ZaneMorris/RomniBot/RomniBot_BOM.xlsx

Assy Level 1 | Assy Level 2 | Assy Level 3 | Description | Qty. | Type | Material
OD_A1 |  |  | Chassis Assy | 1 | ASSY | N/A
 | OD_A1_A1 |  | Electronics Assy | 1 | ASSY | N/A
 |  | OD_A1_A1_001 | Electronic Bay Baseplate | 1 | Print | PLA
 |  | OD_A1_A1_002 | Antenna Mount | 1 | Print | PLA
 |  | OD_A1_A1_003 | FHCS cntsk washer (for PCB mounts) | 16 | Print | PLA
 |  | OD_A1_A1_004 | Perfboard 1 | 1 | Elec. | Perfboard
 |  | 91420A020 | M2.5 x 0.45mm x 10mm FHCS | 18 | Hardware | Steel
 |  | N/A | Male 2.54mm headers | 21 | Elec. | N/A
 |  | LM2596S | buck converter (breakout board) (https://www.amazon.ca/gp/product/B07VVXF7YX/ref=ppx_yo_dt_b_asin_title_o05_s00?ie=UTF8&psc=1) | 2 | Elec. | N/A
 |  | L298N | DC dual motor driver (breakout board) (https://www.amazon.ca/gp/product/B07GTCWN9Z/ref=ppx_yo_dt_b_asin_title_o00_s01?ie=UTF8&psc=1) | 2 | Elec. | N/A
 |  | NRF24L01 | Transciever module with booster antenna (https://www.amazon.ca/Jweweunyu-NRF24L01-Transceiver-Antenna-Wireless/dp/B0B7QG4HV8) | 1 | Elec. | N/A
 | OD_A1_001 |  | Chassis Assy | 1F 1R | ASSY | N/A
 | OD_A1_002 |  | #10-24 UNC threaded rod | 2 | Hardware | Mild Steel
 | OD_A1_003 |  | Electronic bay lid | 1 | Laser | 1/16" Acrylic
 | OD_A1_004 |  | Electronic baseplate standoffs | 4 | Print | PLA
 | OD_G_A1 |  | Front motor bracket Assy | 4 | ASSY | N/A
 |  | OD_G_A1_001 | Front motor bracket | 1 | Print | PLA
 |  | N/A | M3 threaded brass heat-set inserts (https://www.amazon.ca/gp/product/B087N4LVD1/ref=ppx_yo_dt_b_asin_title_o03_s00?ie=UTF8&psc=1) | 3 | Hardware | Brass
 | OD_G_A2 |  | Rear motor bracket Assy | 4 | ASSY | N/A
 |  | OD_G_A2_001 | Rear motor bracket | 1 | Print | PLA
 |  | N/A | M3 threaded brass heat-set inserts (https://www.amazon.ca/gp/product/B087N4LVD1/ref=ppx_yo_dt_b_asin_title_o03_s00?ie=UTF8&psc=1) | 2 | Hardware | Brass
 | 91290A175 |  | M4 x 0.7 x 45mm SHCS - Electronics bay standoff bolt | 4 | Hardware | Black Oxide Steel
 | 91420A020 |  | M2.5 x 0.45mm x 10mm FHCS - Electronic bay lid screws | motor screws | 12 | Hardware | Zinc-Plated Steel
 | 90593A003 |  | M4 x 0.7mm nut | 4 | Hardware | Black Oxide Steel
 | 91290a117 |  | M3 x 0.5mm x 12mm SHCS | 20 | Hardware | Black Oxide Steel
 | 90480A011 |  | #10-24 UNC nut | 4 | Hardware | Zinc-Plated Steel
 | 97416A115 |  | #10 washer | 4 | Hardware | Black Oxide Steel
 | N/A |  | 12V DC motor, D-shaft (https://www.amazon.ca/gp/product/B07D297L9F/ref=ppx_yo_dt_b_asin_title_o07_s00?ie=UTF8&psc=1) | 4 | Elec. | N/A
 | N/A |  | ERB 3300 mAh 60C 14.8V LiPo battery (w Deans connector) (https://www.amazon.ca/gp/product/B06XKQJZ8D/ref=ppx_yo_dt_b_asin_title_o00_s00?ie=UTF8&psc=1) | 1 | Elec. | N/A
 | N/A |  | T Plug - to - cable adapter (12 AWG output) (https://www.amazon.ca/gp/product/B07QM1WS2J/ref=ppx_yo_dt_b_asin_title_o04_s00?ie=UTF8&psc=1) | 1 | Elec. | N/A
 | KCDY-101 |  | 8A, 250 VAC | 10A, 125 VAC SPST power switch | 1 | Elec. | N/A
 | N/A |  | MINI-DVM-3.0-30V-GREEN-LED | 1 | Elec. | N/A
OD_A2 |  |  | Wheel Config 1 | 2 | ASSY | N/A
 | OD_A2_001 |  | Mecanum wheel rim | 1R 1L | Print | PLA
 | OD_G_001 |  | Wheel spacer | 3 | Print | PLA
 | OD_G_002 |  | Roller | 9 | Print | PLA
 | OD_G_003 |  | Roller pin | 9 | Print | PLA
 | OD_G_004 |  | Motor-Wheel adapter | 1 | Print | PLA
 | 6658K724 |  | Oil-embedded bronze bushing (NOT USED) | 18 | Hardware | 841 Bearing Bronze
 | 91290A268 |  | M5 x 0.8mm x 60mm SHCS | 3 | Hardware | Black Oxide Steel
 | 98541A113 |  | 5mm OD shaft external retaining ring | 9 | Hardware | Black Oxide Steel
 | 91390A101 |  | M3 x 0.5mm x 8mm cupped marring set screw | 1 | Hardware | Black Oxide Steel
 | 90593A001 |  | M3 x 0.5mm nut | 1 | Hardware | Black Oxide Steel
 | 91880A037 |  | M5 x 0.8mm cap nut (NOT USED - currently M5 x 0.8mm nut - 90592A095) | 3 | Hardware | Zinc-Plated Steel
OD_A3 |  |  | Wheel Config 2 | 2 | ASSY | N/A
 | OD_A3_001 |  | Mecanum wheel rim | 1R 1L | Print | PLA
 | OD_G_001 |  | Wheel spacer | 3 | Print | PLA
 | OD_G_002 |  | Roller | 9 | Print | PLA
 | OD_G_003 |  | Roller pin | 9 | Print | PLA
 | OD_G_004 |  | Motor-Wheel adapter | 1 | Print | PLA
 | 6658K724 |  | Oil-embedded bronze bushing (NOT USED) | 18 | Hardware | 841 Bearing Bronze
 | 91290A268 |  | M5 x 0.8mm x 60mm SHCS | 3 | Hardware | Black Oxide Steel
 | 98541A113 |  | 5mm OD shaft external retaining ring | 9 | Hardware | 1060 Spring Steel
 | 91390A101 |  | M3 x 0.5mm x 8mm cupped marring set screw | 1 | Hardware | Black Oxide Steel
 | 90593A001 |  | M3 x 0.5mm nut | 1 | Hardware | Black Oxide Steel
 | 91880A037 |  | M5 x 0.8mm cap nut (NOT USED - currently M5 x 0.8mm nut - 90592A095) | 3 | Hardware | Zinc-Plated Steel
Other Useful Links
General M3/M4/M5 SHCS and Nuts (https://www.amazon.ca/gp/product/B0734NVR48/ref=ppx_yo_dt_b_asin_title_o02_s00?ie=UTF8&psc=1)
Solid core 22 AWG wire (https://www.amazon.ca/gp/product/B0791C1XHK/ref=ppx_yo_dt_b_asin_title_o02_s00?ie=UTF8&psc=1)
Heat shrink (https://www.amazon.ca/gp/product/B07SMBDLGQ/ref=ppx_yo_dt_b_asin_title_o04_s00?ie=UTF8&psc=1)
