ZaneMorris/RomniBot/CAD/Electronics/NRF24L01L+Antenna.SLDASM

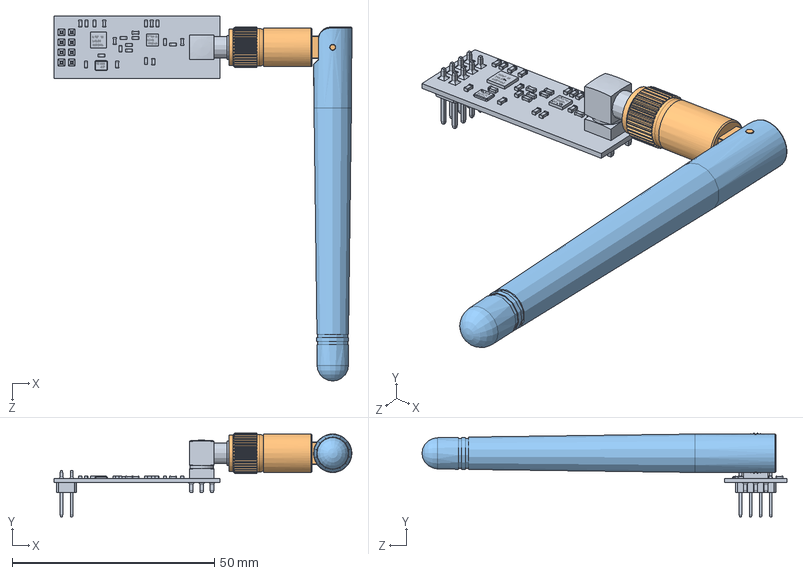
[picture p1: CAD file, 2023-05-12]
CAD/Electronics/NRF24L01L+Antenna.SLDASM
73.7 x 20.7 x 90.2 mm
NRF24L01L
Antenna base
Antenna top
