ZaneMorris/RomniBot/CAD/OD_A2.SLDASM

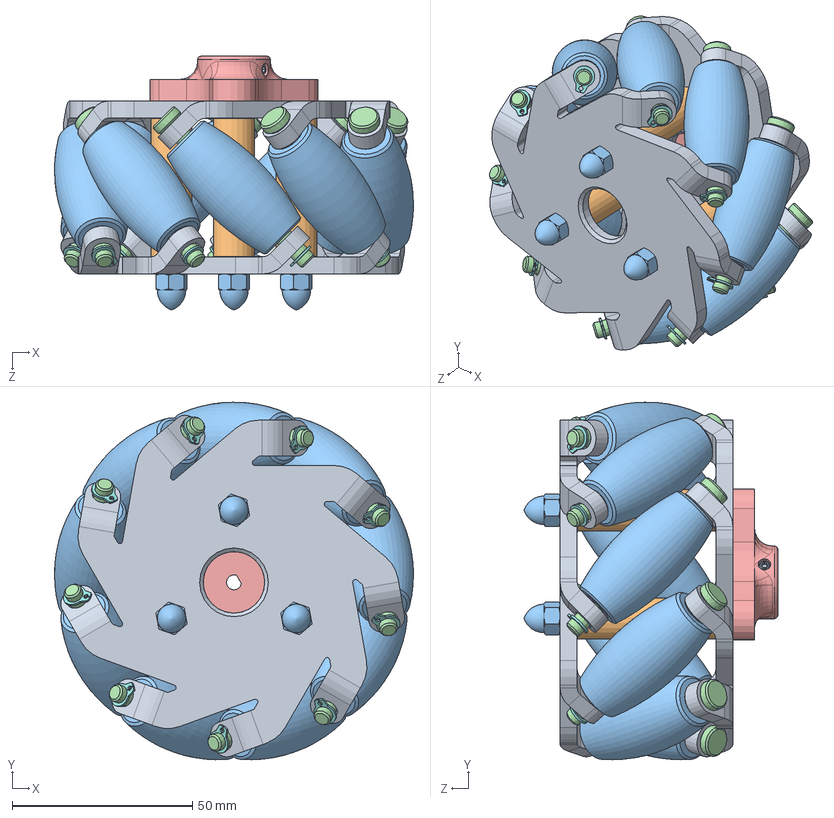
[picture p2: CAD file, 2023-05-12]
CAD/OD_A2.SLDASM
99.6 x 99.2 x 70.5 mm
OD_A2_001 x 2
OD_G_001 x 3
OD_G_002 x 9
OD_G_003 x 9
OD_G_004
6658K724 x 18
91290A268 x 3
98541A113 x 9
91390A101
90593A001
91880A037 x 3
