ZaneMorris/RomniBot/CAD/Electronics/Antenna assy.SLDASM

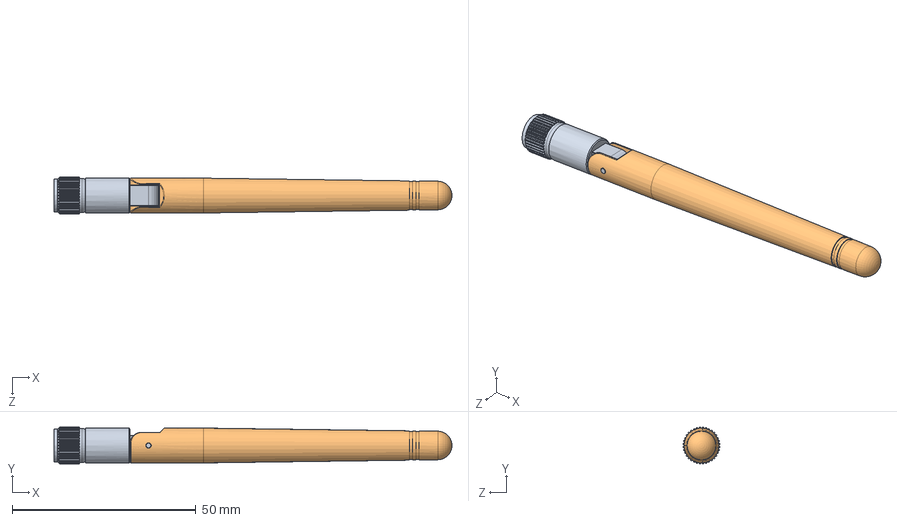
[picture p3: CAD file, 2023-05-12]
CAD/Electronics/Antenna assy.SLDASM
108.2 x 9.98 x 9.98 mm
Antenna base
Antenna top
