ZaneMorris/RomniBot/CAD/OD_A1_A1.SLDASM

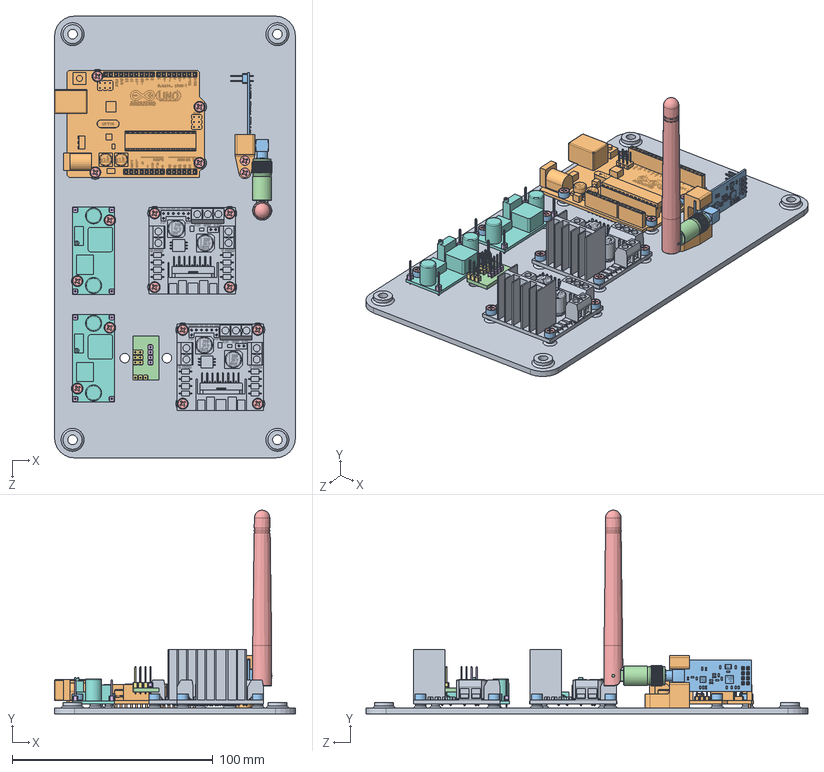
[picture p4: CAD file, 2023-05-12]
CAD/OD_A1_A1.SLDASM
120.0 x 101.5 x 220.0 mm
OD_A1_A1_001
OD_A1_A1_002
OD_A1_A1_003 x 16
OD_A1_A1_004
91420A020 x 18
1x1 Male Pin Header.step x 8
1x3 Male Pin Header.step x 3
LM2596S x 2
L298N x 2
Arduino UNO
NRF24L01L
Antenna base
Antenna top
1x4 Male Pin Header.step
