ZaneMorris/RomniBot/CAD/OD_G_A1.SLDASM

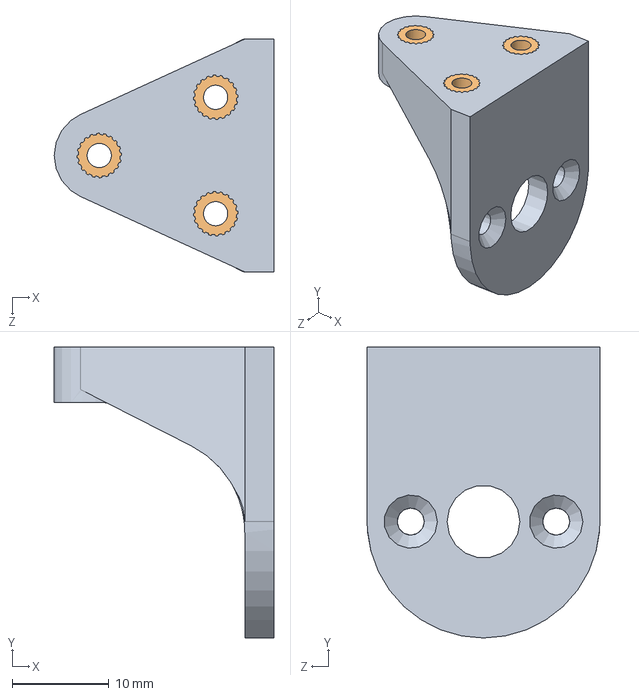
[picture p5: CAD file, 2023-05-12]
CAD/OD_G_A1.SLDASM
22.6 x 30.0 x 24.0 mm
OD_G_A1_001
M3_BrassInsert x 3
