ZaneMorris/RomniBot/CAD/OD_A3.SLDASM

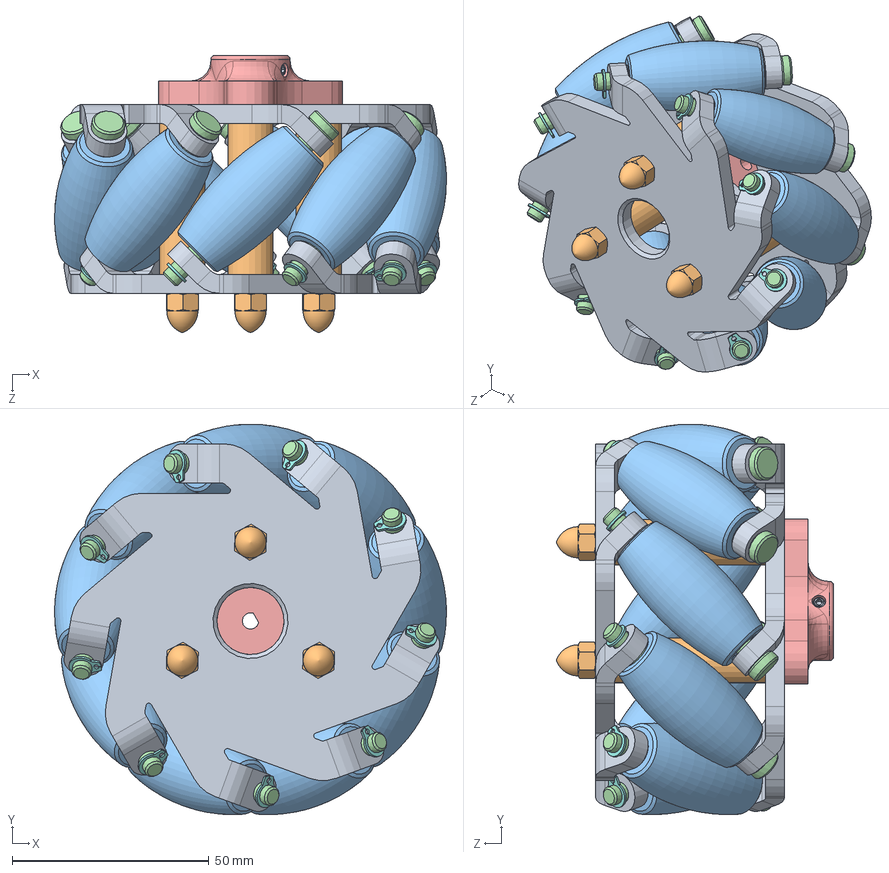
[picture p6: CAD file, 2023-05-12]
CAD/OD_A3.SLDASM
99.6 x 99.2 x 70.5 mm
OD_A3_001 x 2
OD_G_001 x 3
OD_G_002 x 9
OD_G_003 x 9
OD_G_004
6658K724 x 2
91290A268 x 3
98541A113 x 9
91390A101
91880A037 x 3
