ZaneMorris/RomniBot/CAD/OD_G_A2.SLDASM

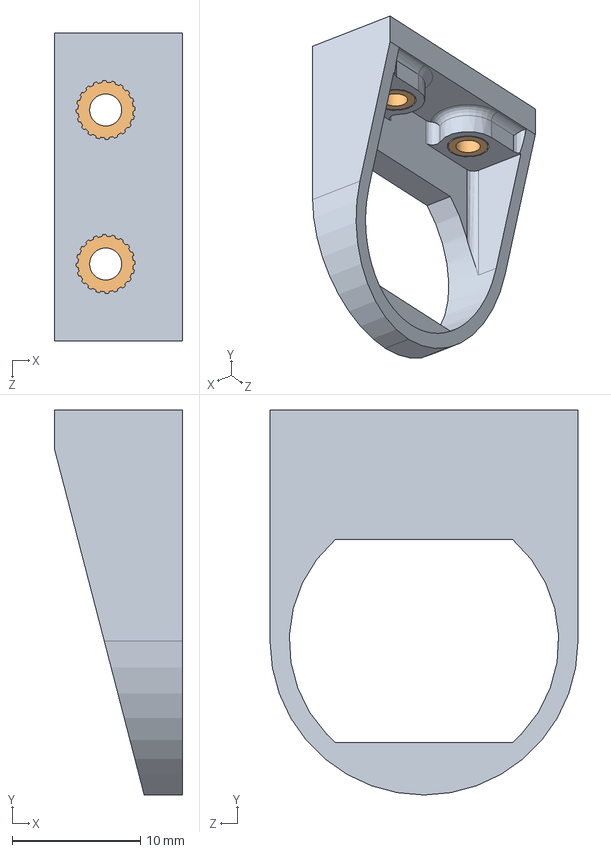
[picture p7: CAD file, 2023-05-12]
CAD/OD_G_A2.SLDASM
10.0 x 30.0 x 24.0 mm
OD_G_A2_001
M3_BrassInsert x 2
