ZaneMorris/RomniBot/CAD/Electronics/NRF24L01L.SLDPRT

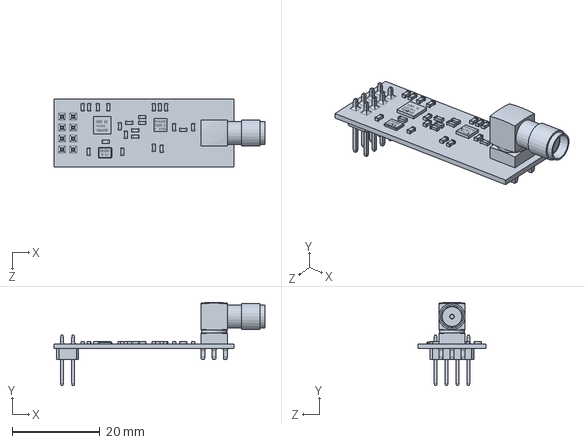
[picture p8: CAD file, 2023-05-12]
CAD/Electronics/NRF24L01L.SLDPRT
48.1 x 19.0 x 15.5 mm
