ZaneMorris/RomniBot/CAD/OD_A1_001.SLDPRT

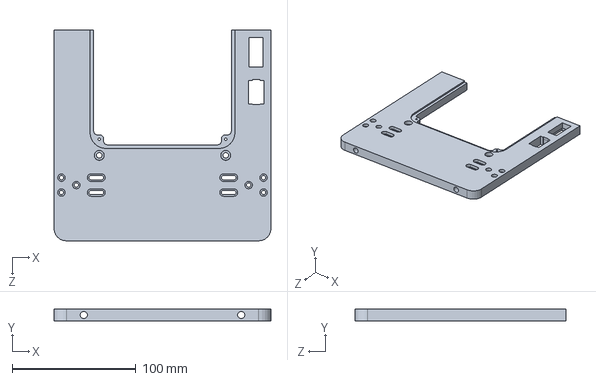
[picture p9: CAD file, 2023-05-12]
CAD/OD_A1_001.SLDPRT
175.0 x 9.53 x 170.0 mm
