ZaneMorris/RomniBot/CAD/Electronics/Antenna top.SLDPRT

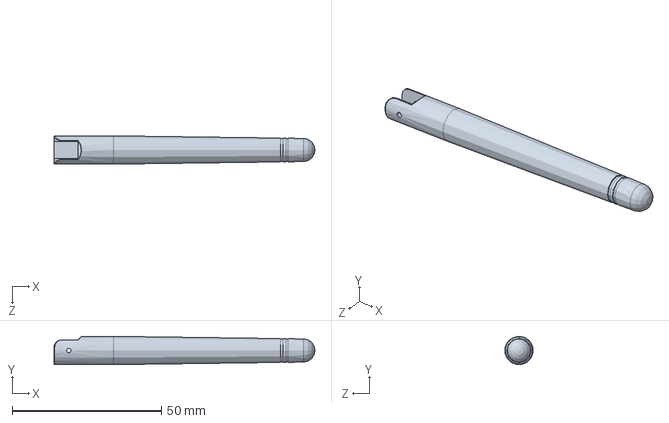
[picture p10: CAD file, 2023-05-12]
CAD/Electronics/Antenna top.SLDPRT
87.5 x 9.50 x 9.50 mm
