ZaneMorris/RomniBot/CAD/OD_A1_004.SLDPRT

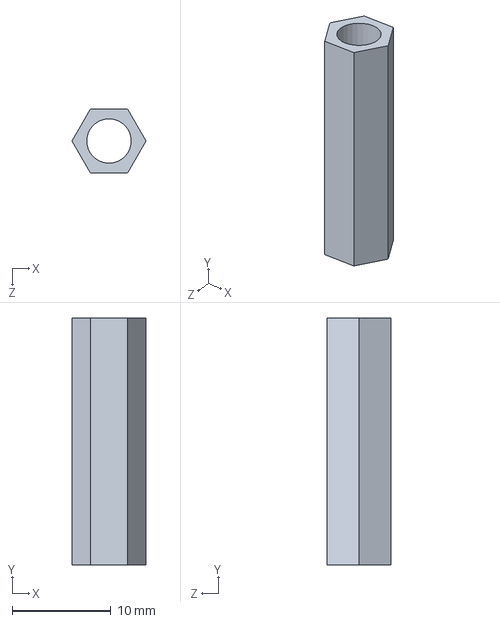
[picture p11: CAD file, 2023-05-12]
CAD/OD_A1_004.SLDPRT
7.51 x 25.0 x 6.50 mm
