ZaneMorris/RomniBot/CAD/OD_G_004.SLDPRT

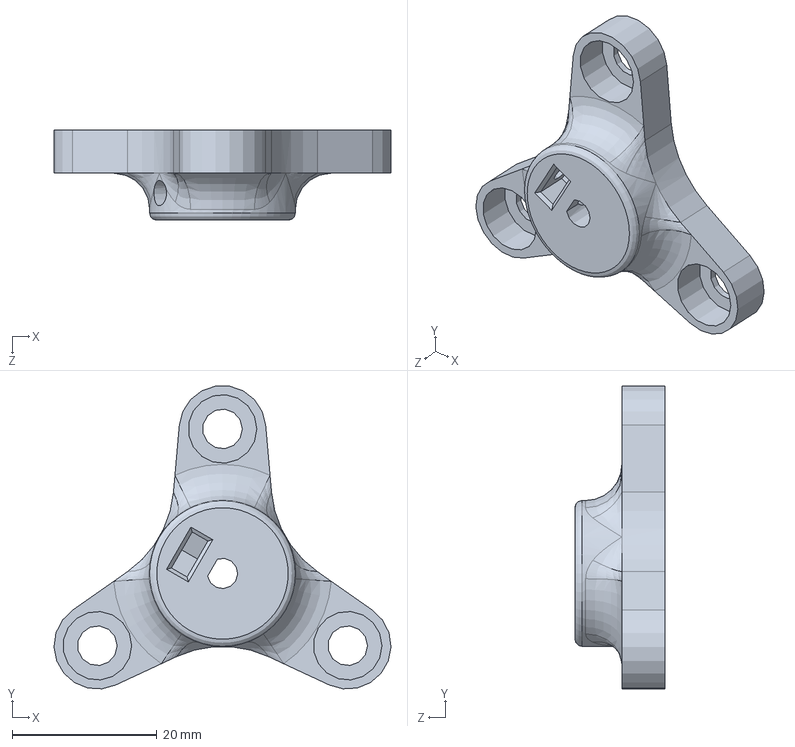
[picture p12: CAD file, 2023-05-12]
CAD/OD_G_004.SLDPRT
46.6 x 41.9 x 12.5 mm
