ZaneMorris/RomniBot/CAD/Electronics/LM2596S.SLDPRT

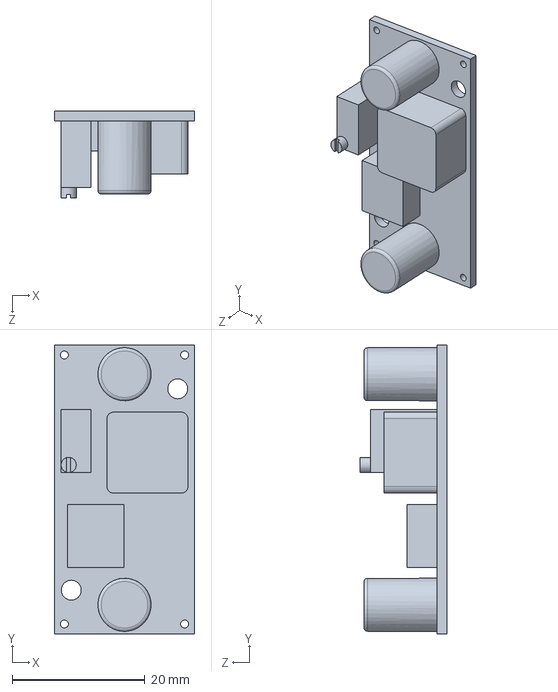
[picture p13: CAD file, 2023-05-12]
CAD/Electronics/LM2596S.SLDPRT
21.1 x 43.5 x 13.1 mm
