ZaneMorris/RomniBot/CAD/Electronics/ERB_3300mAh_60C_14.8V.SLDPRT

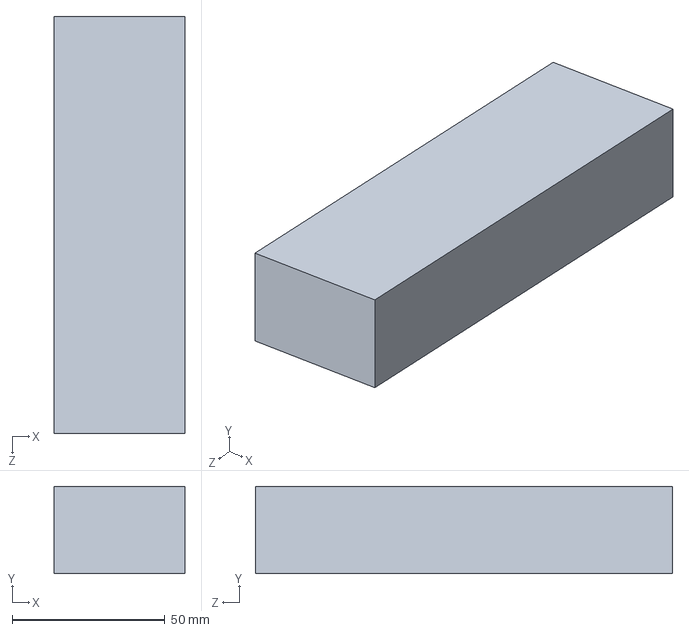
[picture p14: CAD file, 2023-05-12]
CAD/Electronics/ERB_3300mAh_60C_14.8V.SLDPRT
42.9 x 28.6 x 136.5 mm
