ZaneMorris/RomniBot/CAD/OD_G_A2_001.SLDPRT

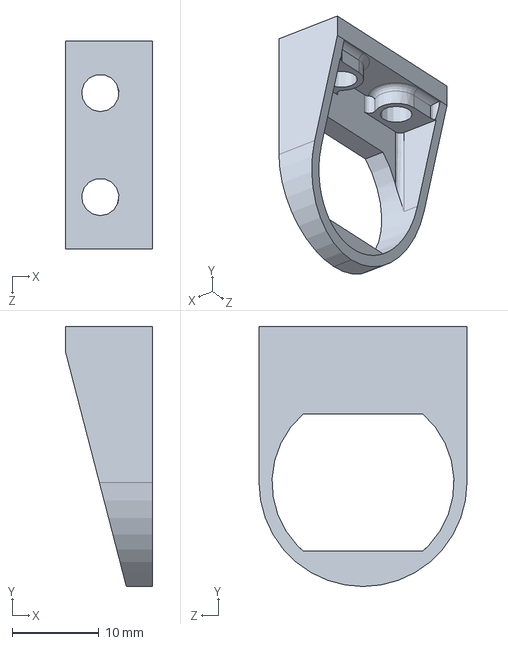
[picture p15: CAD file, 2023-05-12]
CAD/OD_G_A2_001.SLDPRT
10.0 x 30.0 x 24.0 mm
