ZaneMorris/RomniBot/CAD/Electronics/1x3 Male Pin Header.STEP

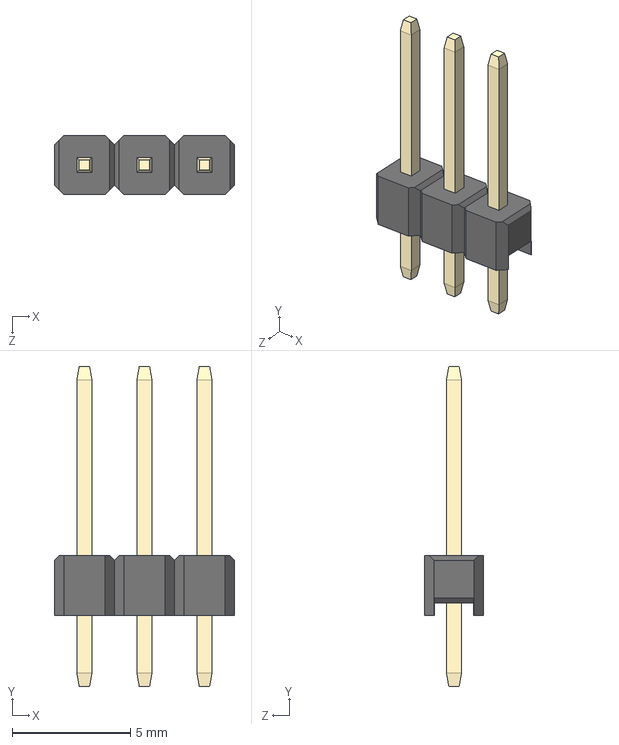
[picture p16: CAD file, 2023-05-12]
CAD/Electronics/1x3 Male Pin Header.STEP
7.63 x 13.5 x 2.50 mm
