ZaneMorris/RomniBot/CAD/OD_A1_A1_004.SLDPRT

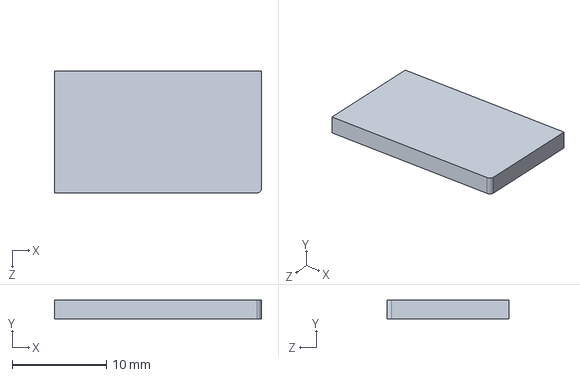
[picture p17: CAD file, 2023-05-12]
CAD/OD_A1_A1_004.SLDPRT
22.0 x 2.00 x 13.0 mm
