ZaneMorris/RomniBot/CAD/Electronics/switch.SLDPRT

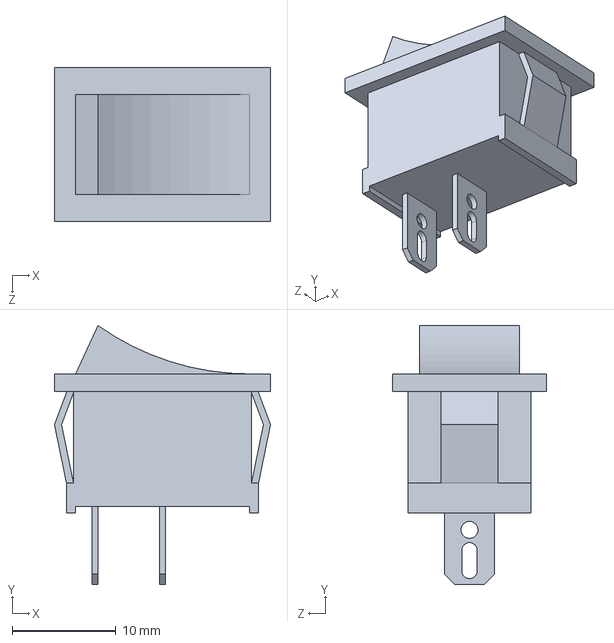
[picture p18: CAD file, 2023-05-12]
CAD/Electronics/switch.SLDPRT
20.8 x 24.9 x 14.8 mm
