ZaneMorris/RomniBot/CAD/Hardware/M3_BrassInsert.SLDPRT

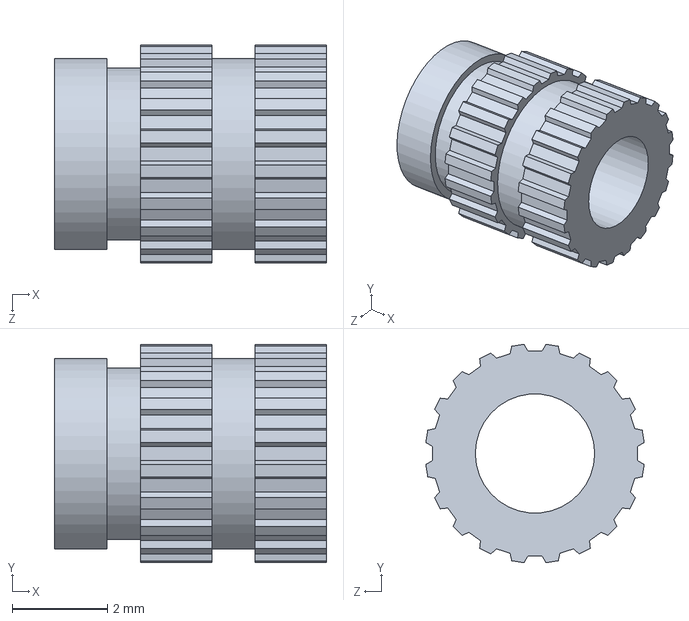
[picture p19: CAD file, 2023-05-12]
CAD/Hardware/M3_BrassInsert.SLDPRT
5.70 x 4.58 x 4.58 mm
