ZaneMorris/RomniBot/CAD/OD_A1_A1_001.SLDPRT

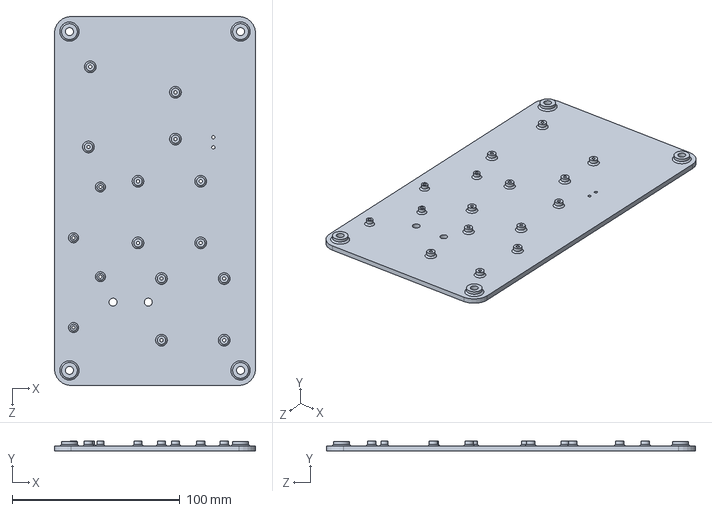
[picture p20: CAD file, 2023-05-12]
CAD/OD_A1_A1_001.SLDPRT
120.0 x 6.00 x 220.0 mm
