ZaneMorris/RomniBot/CAD/OD_A1_003.SLDPRT

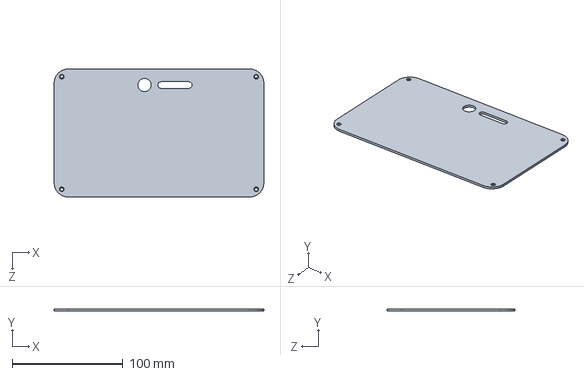
[picture p21: CAD file, 2023-05-12]
CAD/OD_A1_003.SLDPRT
190.0 x 2.03 x 116.0 mm
