ZaneMorris/RomniBot/CAD/OD_A1_A1_003.SLDPRT

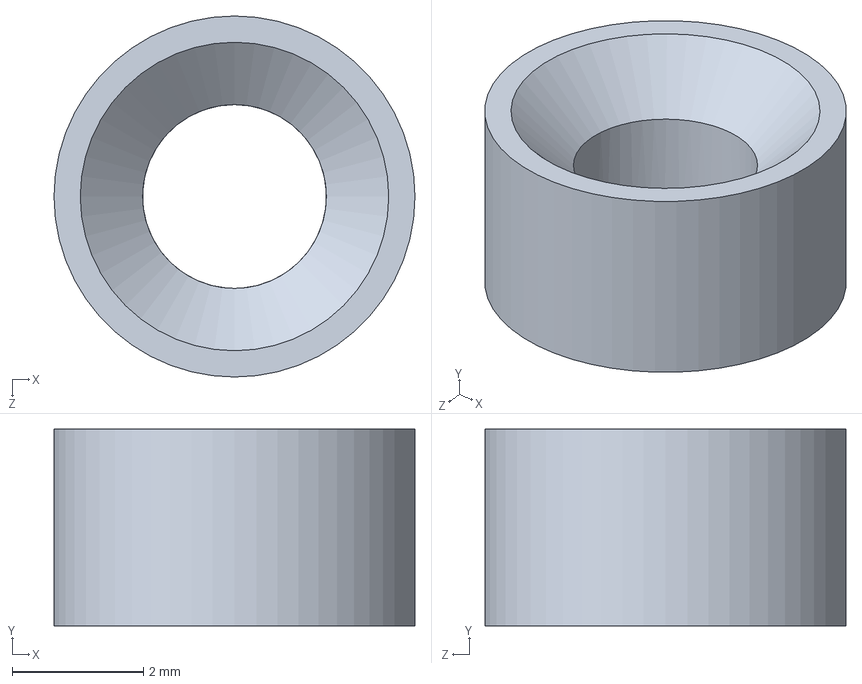
[picture p22: CAD file, 2023-05-12]
CAD/OD_A1_A1_003.SLDPRT
5.50 x 3.00 x 5.50 mm
