ZaneMorris/RomniBot/CAD/Electronics/Arduino UNO.SLDPRT

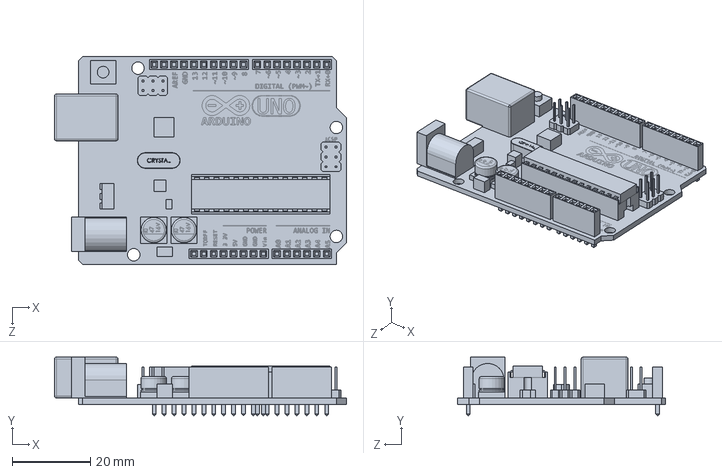
[picture p23: CAD file, 2023-05-12]
CAD/Electronics/Arduino UNO.SLDPRT
74.8 x 15.1 x 53.3 mm
