ZaneMorris/RomniBot/CAD/Electronics/L298N.SLDPRT

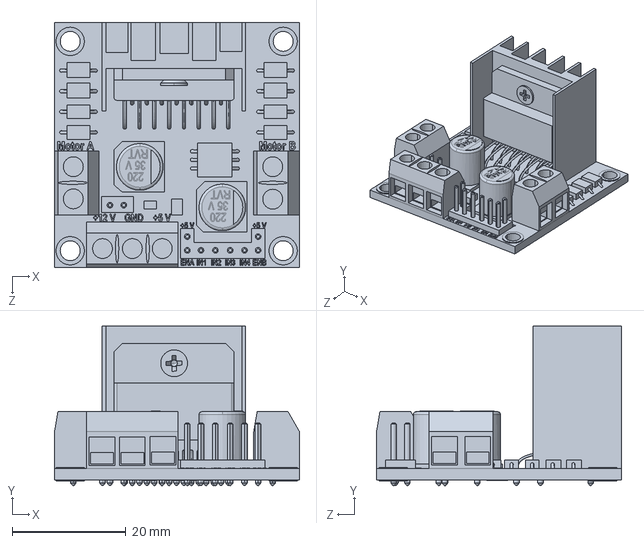
[picture p24: CAD file, 2023-05-12]
CAD/Electronics/L298N.SLDPRT
43.0 x 28.0 x 43.0 mm
