ZaneMorris/RomniBot/CAD/OD_A1_002.SLDPRT

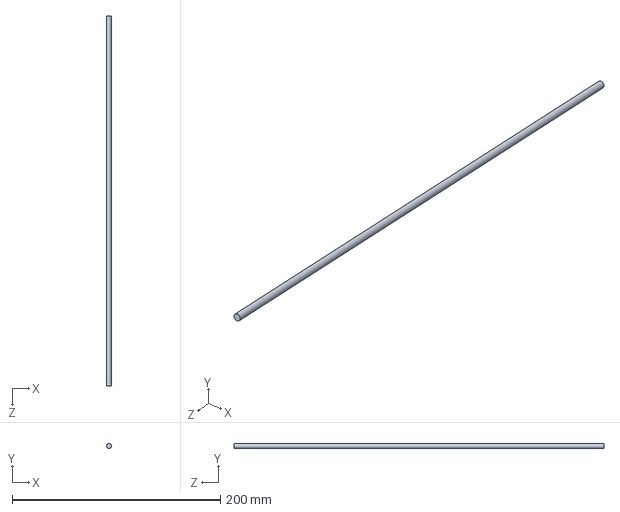
[picture p25: CAD file, 2023-05-12]
CAD/OD_A1_002.SLDPRT
4.76 x 4.76 x 355.6 mm
