ZaneMorris/RomniBot/CAD/Electronics/1x1 Male Pin Header.step.SLDPRT

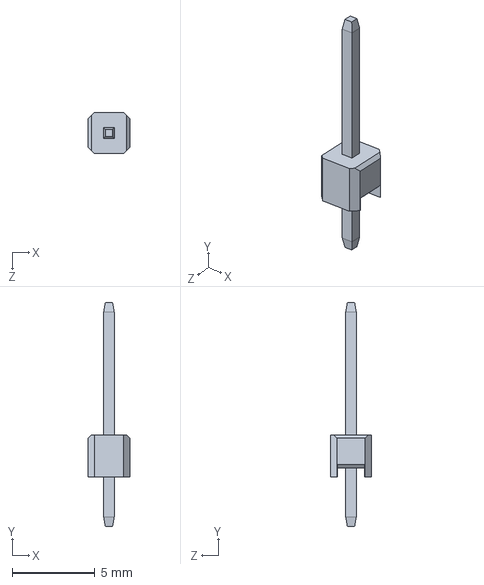
[picture p26: CAD file, 2023-05-12]
CAD/Electronics/1x1 Male Pin Header.step.SLDPRT
2.55 x 13.5 x 2.50 mm
