ZaneMorris/RomniBot/CAD/OD_A2_001.SLDPRT

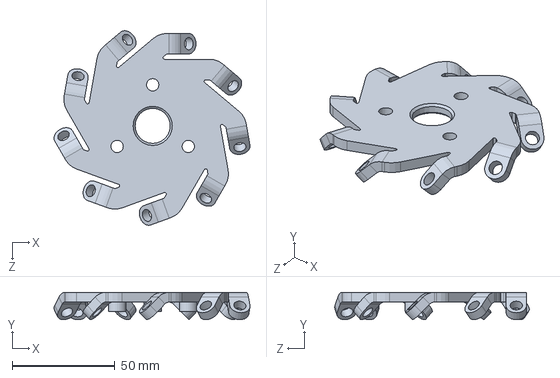
[picture p27: CAD file, 2023-05-12]
CAD/OD_A2_001.SLDPRT
95.4 x 13.3 x 94.8 mm
