ZaneMorris/RomniBot/CAD/Electronics/1x4 Male Pin Header.STEP

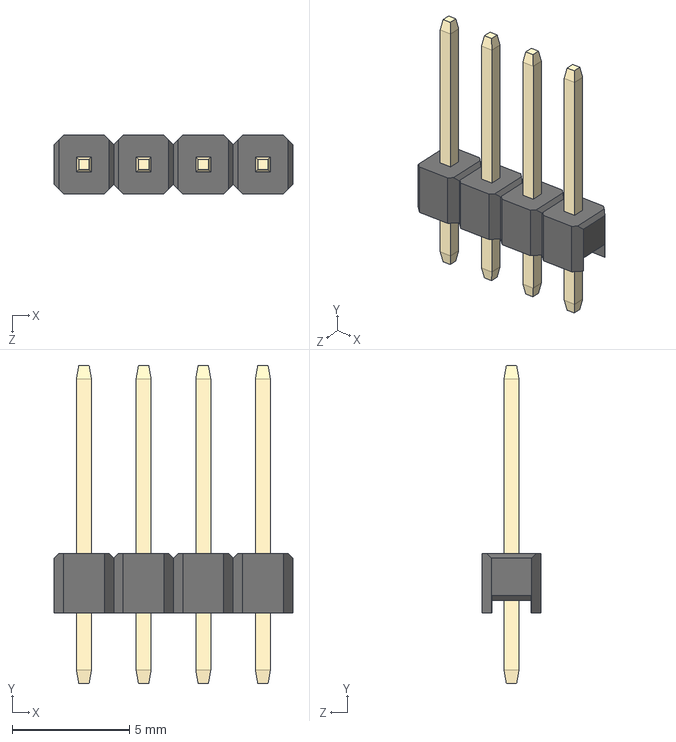
[picture p28: CAD file, 2023-05-12]
CAD/Electronics/1x4 Male Pin Header.STEP
10.2 x 13.5 x 2.50 mm
