ZaneMorris/RomniBot/CAD/OD_G_001.SLDPRT

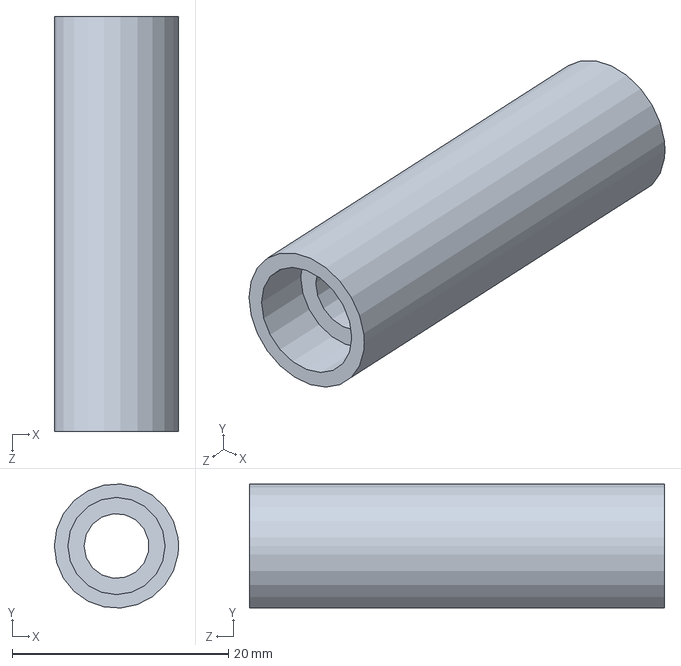
[picture p29: CAD file, 2023-05-12]
CAD/OD_G_001.SLDPRT
11.5 x 11.5 x 38.4 mm
