ZaneMorris/RomniBot/CAD/Electronics/DVM.SLDPRT

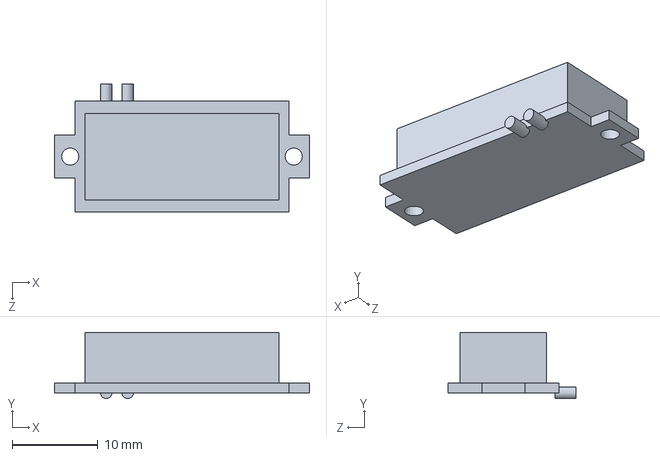
[picture p30: CAD file, 2023-05-12]
CAD/Electronics/DVM.SLDPRT
29.8 x 7.73 x 15.0 mm
