ZaneMorris/RomniBot/CAD/OD_G_003.SLDPRT

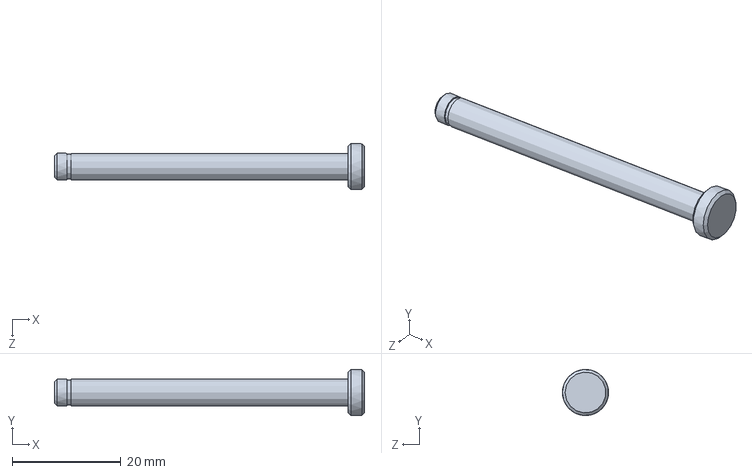
[picture p31: CAD file, 2023-05-12]
CAD/OD_G_003.SLDPRT
57.0 x 8.46 x 8.50 mm
