ZaneMorris/RomniBot/CAD/Electronics/Antenna base.SLDPRT

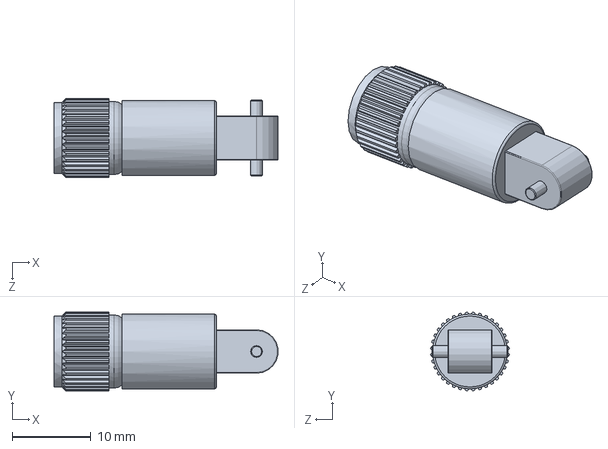
[picture p32: CAD file, 2023-05-12]
CAD/Electronics/Antenna base.SLDPRT
28.4 x 9.98 x 9.98 mm
