ZaneMorris/RomniBot/CAD/Electronics/Motor3.SLDPRT

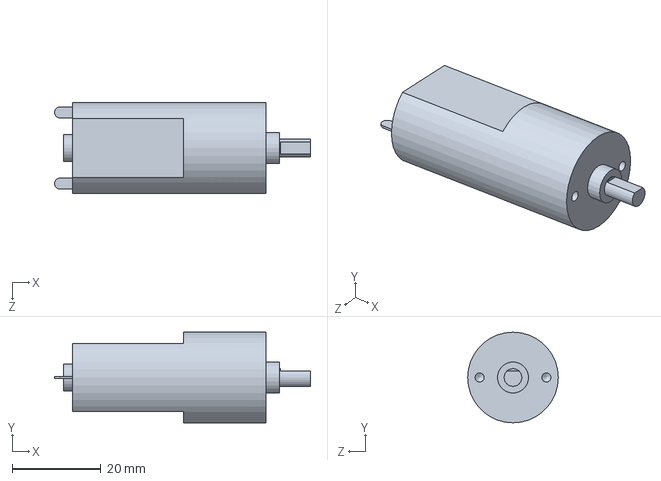
[picture p33: CAD file, 2023-05-12]
CAD/Electronics/Motor3.SLDPRT
57.6 x 20.4 x 20.4 mm
