ZaneMorris/RomniBot/CAD/OD_G_A1_001.SLDPRT

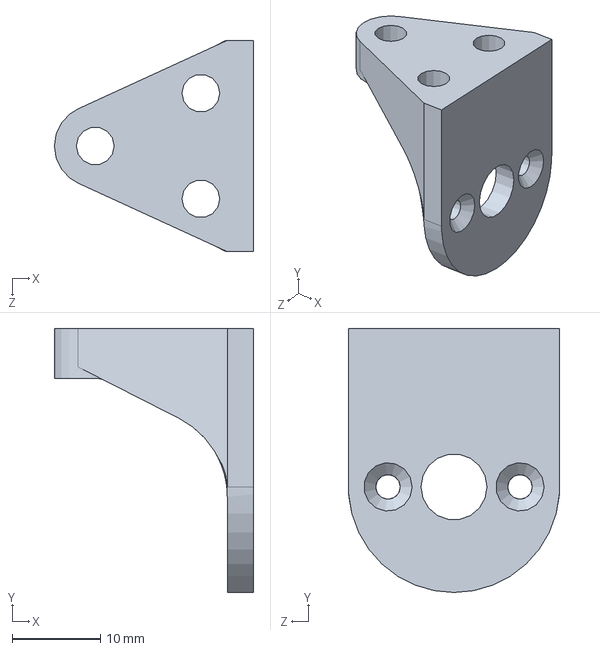
[picture p34: CAD file, 2023-05-12]
CAD/OD_G_A1_001.SLDPRT
22.6 x 30.0 x 24.0 mm
