ZaneMorris/RomniBot/CAD/OD_A1_A1_002.SLDPRT

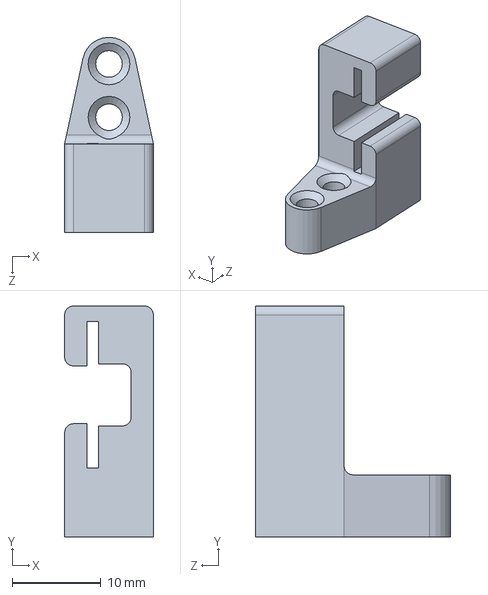
[picture p35: CAD file, 2023-05-12]
CAD/OD_A1_A1_002.SLDPRT
10.0 x 26.0 x 22.0 mm
