ZaneMorris/RomniBot/CAD/OD_G_002.SLDPRT

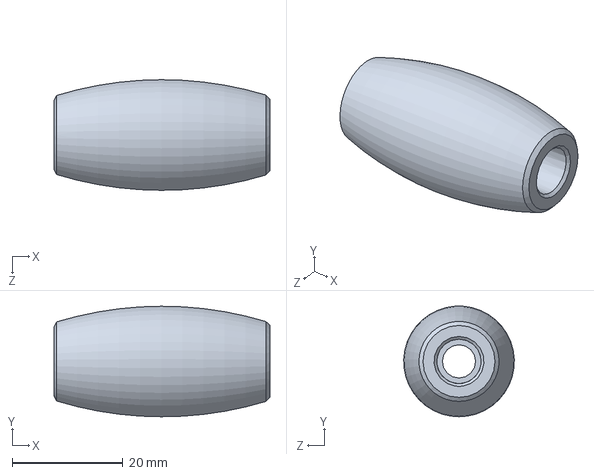
[picture p36: CAD file, 2023-05-12]
CAD/OD_G_002.SLDPRT
39.0 x 20.0 x 20.0 mm
