ZaneMorris/RomniBot/(list of files, cad)

Other CAD files:
CAD/Electronics/1x3 Male Pin Header.step.SLDPRT
CAD/Electronics/1x4 Male Pin Header.step.SLDPRT
CAD/OD_A3_001.SLDPRT
CAD/Hardware/6658K724.SLDPRT
CAD/Hardware/90480A011.SLDPRT
CAD/Hardware/90593A001.SLDPRT
CAD/Hardware/90593A003.SLDPRT
CAD/Hardware/91290A117.SLDPRT
CAD/Hardware/91290A175.SLDPRT
CAD/Hardware/91290A268.SLDPRT
CAD/Hardware/91390A101.SLDPRT
CAD/Hardware/91420A020.SLDPRT
CAD/Hardware/91880A037.SLDPRT
CAD/Hardware/97416A115.SLDPRT
CAD/Hardware/98541A113.SLDPRT
