ZaneMorris/RomniBot/RomniBot_Onboard_Wiring_Schematic.pdf

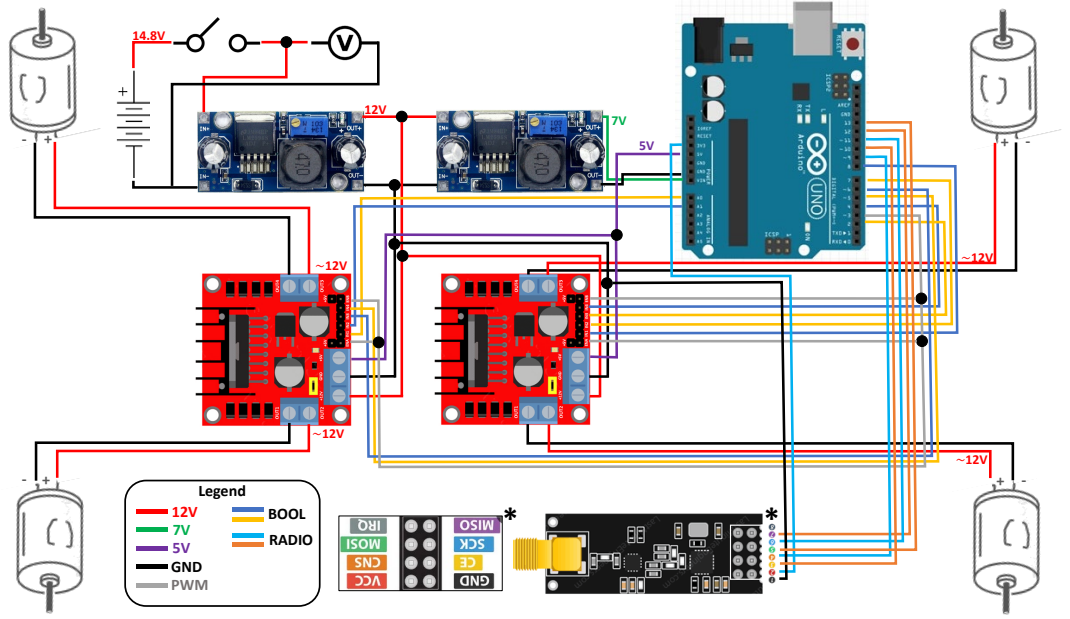
[picture p37: page 1]
Legend; 12V 7V 5V GND PWM; BOOL RADIO
