ZaneMorris/RomniBot/(commit log)

2023-05-12 First commit
    initial upload of CAD and documentation. Rev 1.0
    [1x1 Male Pin Header.step.SLDPRT, 1x3 Male Pin Header.STEP, 1x3 Male Pin Header.step.SLDPRT, 1x4 Male Pin Header.STEP, 1x4 Male Pin Header.step.SLDPRT, 6658K724.SLDPRT, 90480A011.SLDPRT, 90593A001.SLDPRT]
2023-05-14 add arduino sketches for rec/trans
